LakeheadMakerSpace/3dprinting/2017 Fall Design Catapult/images/d78744d5d45de154823a48cb626cd987_preview_featured.jpg

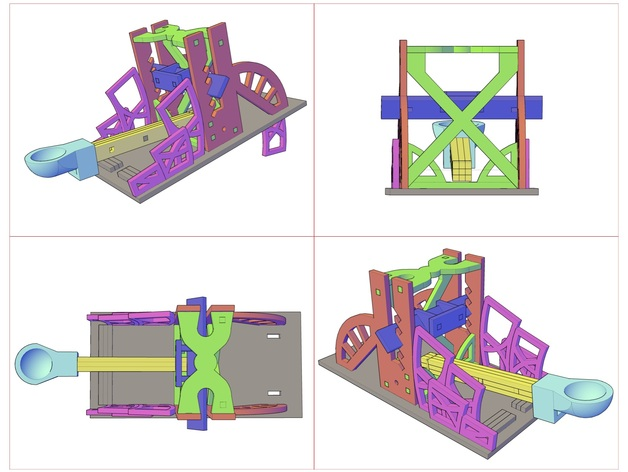
2017 Fall Design Catapult/images/d78744d5d45de154823a48cb626cd987_preview_featured.jpg
