LakeheadMakerSpace/3dprinting/2017 Fall Design Catapult/images/dcf853b14ae63727b5cf67b7840da5ca_preview_featured.jpg

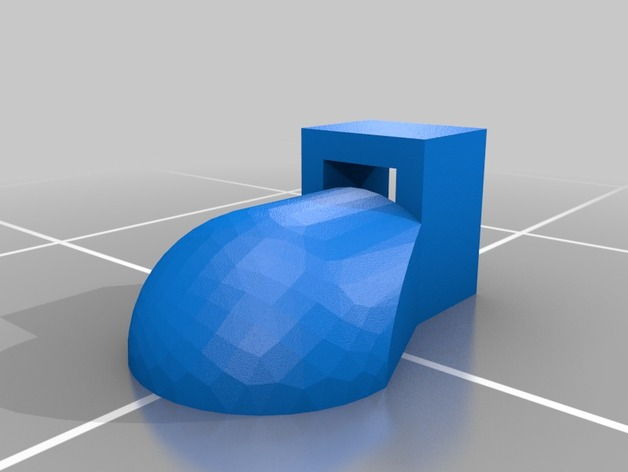
2017 Fall Design Catapult/images/dcf853b14ae63727b5cf67b7840da5ca_preview_featured.jpg
