LakeheadMakerSpace/3dprinting/README.md

# 3d Printing @ Lakehead University Makerspace
This repository contains 3d printed models created by our members.  
To get a model of yours included just submit a pull request or email makerspace.engi@lakeheadu.ca

-- The Makerspace team
