LakeheadMakerSpace/3dprinting/2017 Fall Design Catapult/files/Catapult_Nov_24_-_3.pdf

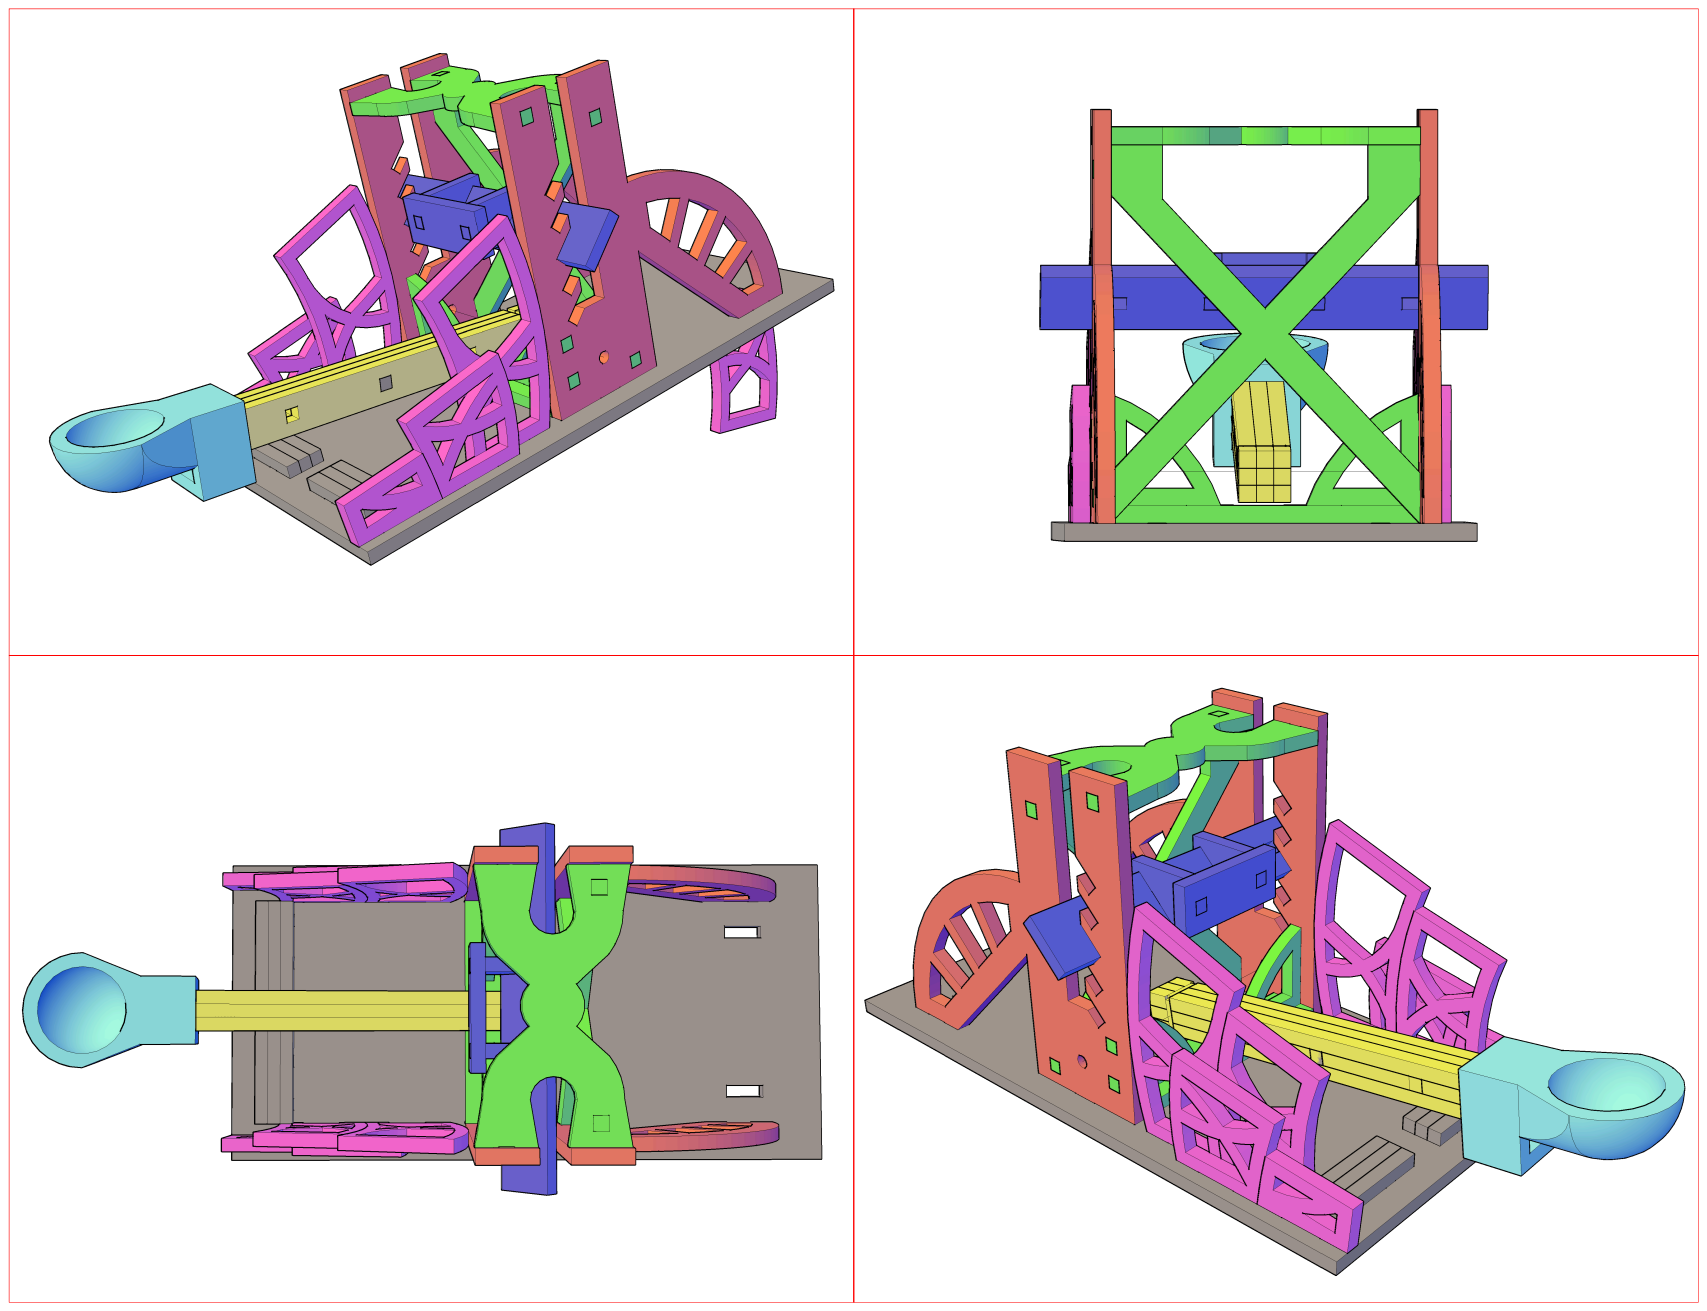
[picture p5: page 1]
