LakeheadMakerSpace/3dprinting/2017 Fall Design Catapult/files/Bucket_Metric_Nov_24_-_3.stl

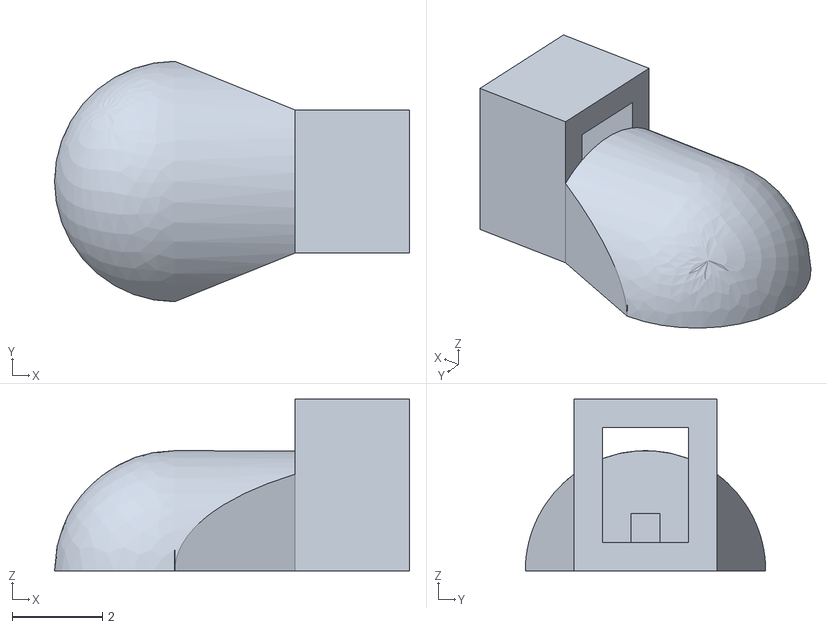
[picture p3: CAD file, 2018-08-22]
2017 Fall Design Catapult/files/Bucket_Metric_Nov_24_-_3.stl
7.87 x 5.33 x 3.81
