LakeheadMakerSpace/3dprinting/2017 Fall Design Catapult/files/Bucket_Imperial_Nov_24_-_3.stl

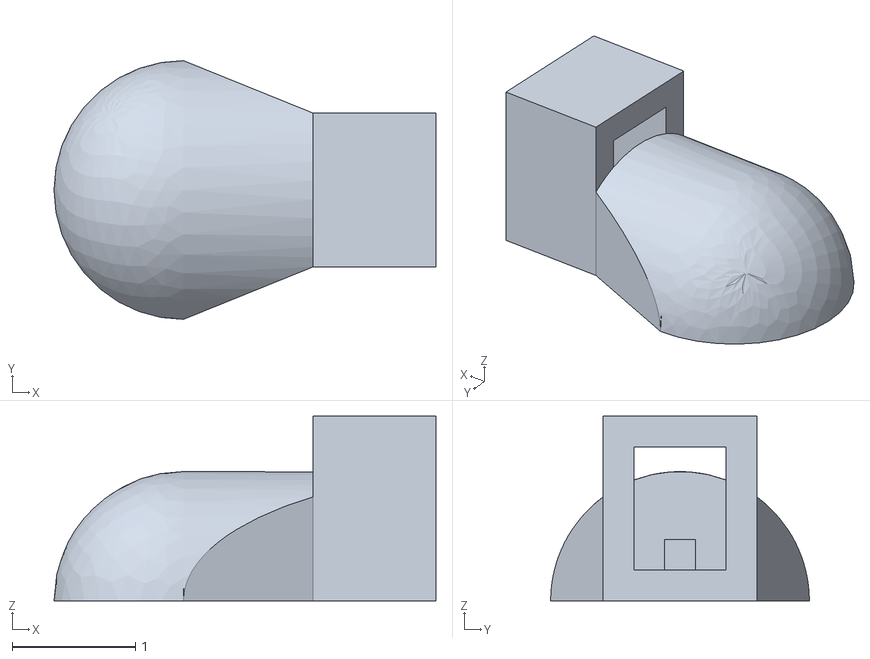
[picture p4: CAD file, 2018-08-22]
2017 Fall Design Catapult/files/Bucket_Imperial_Nov_24_-_3.stl
3.10 x 2.10 x 1.50
