LakeheadMakerSpace/3dprinting/(list of files, cad)

Other CAD files:
2017 Fall Design Catapult/files/Catapult_Nov_28_-_1.dwg
